weaponizedplastic/weaponizedplastic.github.io/README.md

# weaponizedplastic.github.io

## Deploy Notes

    gem install --user-install bundler jekyll
    bundler (will install dependencies)
    bundler exec jekyll serve
