weaponizedplastic/weaponizedplastic.github.io/_posts/2025-04-02-rules.markdown

---
layout: post
title:  "WPFL Rules - 2025"
date:   2025-04-02 12:01:44 -0400
categories: rules
---

# Rules (Final as of 6/13/2025)

## A. General Safety

 1. Robots are only to be powered on **INSIDE THE ARENA**.
 2. **ALL ROBOTS MUST PASS SAFETY TECH**. Safety tech will verify that the robot meets the following three rules:
 3. All weapons must have a physical locking mechanism that prevents unintended startup. The locking mechanism must be engaged at all times the robot is outside the arena.
 4. Robots must be failsafe: when the radio is switched off, they must spin down all weapons and cease all movement.
 5. Battery voltages must not exceed 50V. Batteries must be protected from direct hit. If at any time during a match, the battery becomes exposed the robot will immediately forfeit the match.

Note: it is recommended to have a power indicator light and an easily accessed power switch. These will likely be required at future events.

## B. General Specifications

 1. **ALL WEAPONS MUST BE 3D PRINTED** - that means: NO POLYCARBONATE SHEET GOODS, NO METAL, NO FIRE/EXPLOSIVES, NO FLUIDS, NO EMPS/JAMMING. NO PROJECTILE WEAPONS. Don't be clever here - you will fail safety tech.
 2. Robots should have an active weapon system, actuated by a mechanism other than the drivetrain - robots that lack an active weapon system will generally be scored lower by judges. For the purpose of this section, our definition of "active weapons" follows the [NHRL rules](https://wiki.nhrl.io/wiki/index.php?title=NHRL_Open_Rules_-_2025#Weapon_Systems).
 3. No metal may be used as a cutting/impact edge in a weapon - for example, a screw body or head may not be designed to make contact with an opponents robot.
 4. The robot body should be primarily 3d printed (the use of exotic/engineered plastics, such as fiber reinforced plastics, TPU, etc are allowed). Plastic sheet material not exceeding 1mm in thickness may be used to protect electronics, batteries, and drive mechanisms. The use of "weaker than plastic" materials is allowed - for example: paper, cardboard, styrofoam, etc. Metal fasteners may be used, but should not protrude from the body of the robot.
 5. Maximum Weight: 1kg
 6. Maximum Size: must fit in a box 30cm x 30cm x 30cm AT ALL TIMES
 7. Radios must use the following frequencies: TODO.

## C. Arena Specifications

 1. Arena is approximately 4ft x 4ft x 2ft tall.
 2. Floor is plywood, painted black. Walls are 1/4" Polycarbonate.

## D. Combat Rules

 1. Each match will last for 3 minutes.
 2. Brackets will generally be double elimination.
 3. A competitor may forfeit at any time to prevent further damage to their robot.
 4. If a robot appears incapacitated, judges will start a 10 second count down. If the robot fails to move during this 10 second window, it will forfeit the match.
 5. A robot may only pin and hold a robot for 15 seconds. Judges will instruct competitors when they must separate.
 6. In the event that both robot survive the full match, judges shall decide the winner.
 7. We aim to keep the arena quite active and avoid downtime - competitors should keep this in mind when selecting battery chargers and quantity of batteries to bring. Competitors will have at least 15 minutes between matches, and will not have more than two matches within an hour block of time.

## E. Further Information

 1. Contact weaponizedplastic@gmail.com with any questions.
