weaponizedplastic/weaponizedplastic.github.io/_posts/2026-08-14-austin.markdown

---
layout: post
title:  "Next Up: Austin TX, October 24, 2026"
date:   2026-08-14 11:59:00 -0400
categories: event
---

Weaponized Plastic is hitting the road this fall - with an event at the ASMBLY makerspace in Austin Texas.
We'll continue to update this page with more info as it comes out - for now, here's the save the date poster:

<center>
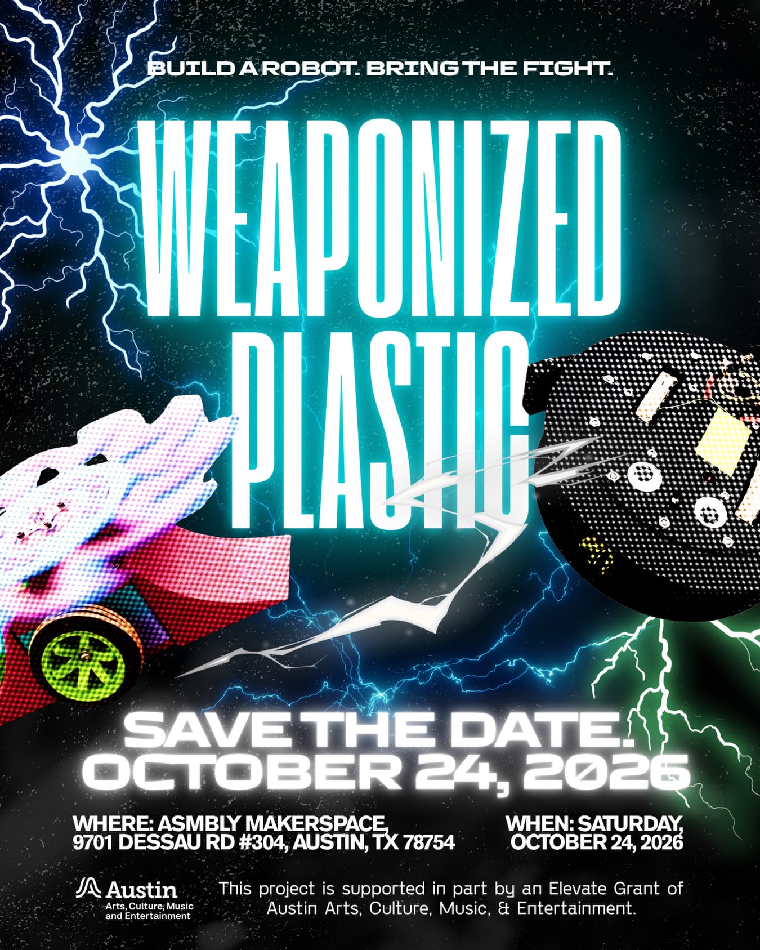
[picture p7: assets/austin_poster_2026.jpg]

</center>
