weaponizedplastic/weaponizedplastic.github.io/assets/tutorial/bottom-plate-v1.stl

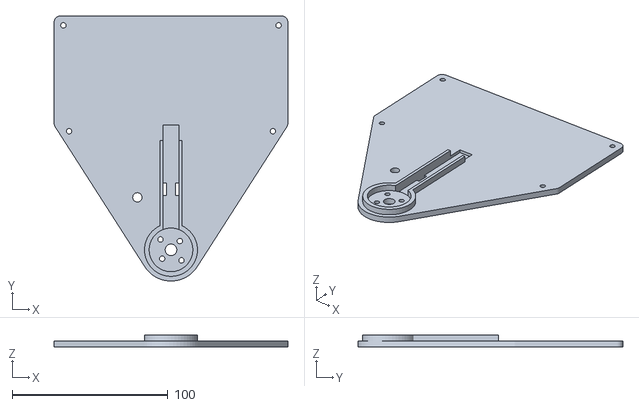
[picture p8: CAD file, 2026-04-16]
assets/tutorial/bottom-plate-v1.stl
150.0 x 170.0 x 8.00
