weaponizedplastic/weaponizedplastic.github.io/assets/tutorial/top-plate-v1.stl

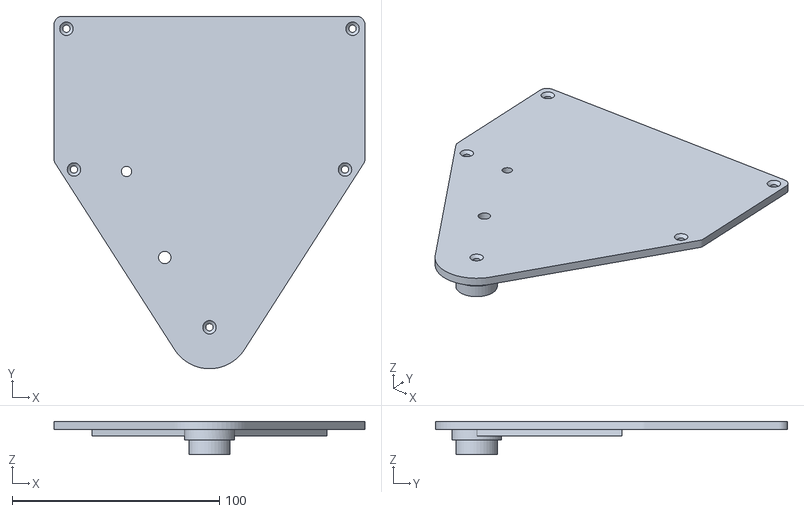
[picture p9: CAD file, 2026-04-16]
assets/tutorial/top-plate-v1.stl
150.0 x 170.0 x 16.0
