weaponizedplastic/weaponizedplastic.github.io/assets/tutorial/weapon-v1.stl

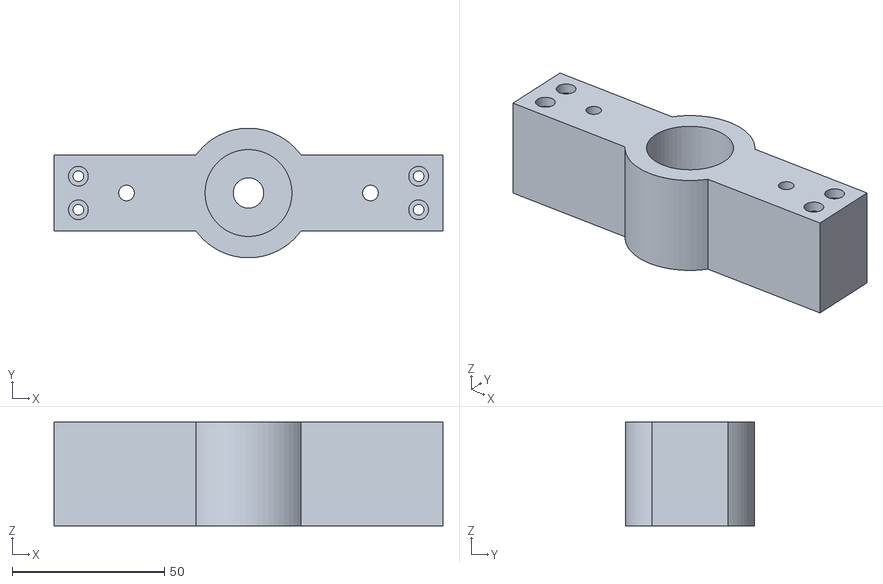
[picture p10: CAD file, 2026-04-16]
assets/tutorial/weapon-v1.stl
127.6 x 42.5 x 34.0
