weaponizedplastic/weaponizedplastic.github.io/assets/tutorial/body-v1.stl

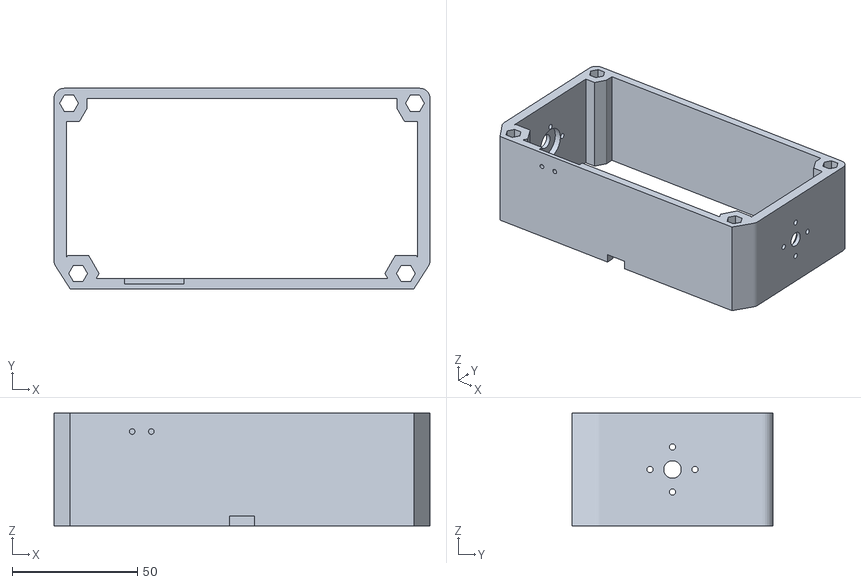
[picture p11: CAD file, 2026-04-16]
assets/tutorial/body-v1.stl
150.0 x 80.0 x 45.0
