weaponizedplastic/weaponizedplastic.github.io/assets/tutorial/rx-setup-4.jpeg

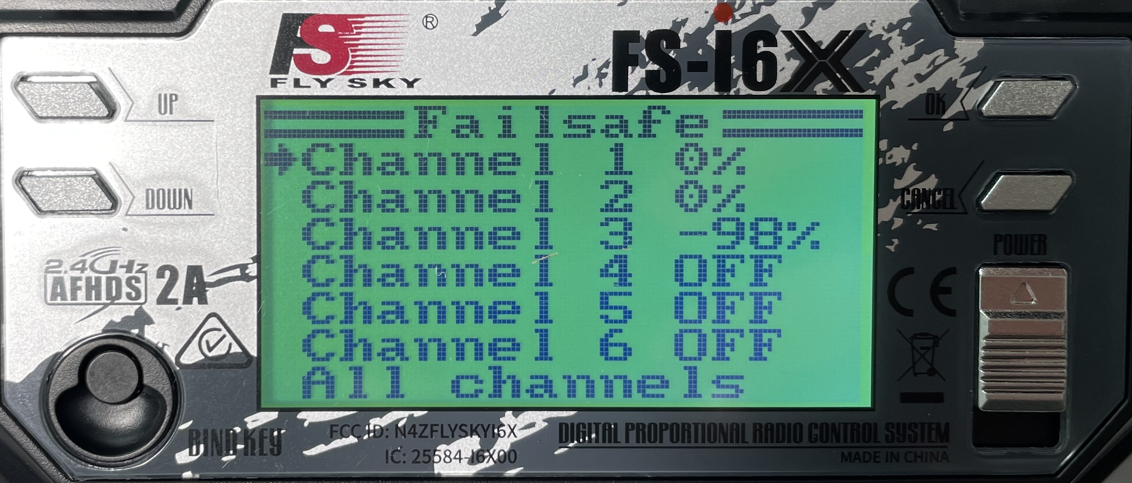
assets/tutorial/rx-setup-4.jpeg
