weaponizedplastic/weaponizedplastic.github.io/(commit log)

2025-03-14 add landing page
2025-04-14 add battery voltage limit
2026-04-09 Specifically allow balsa wood (#4)
    Updated rule regarding allowed materials for robot construction.
2026-04-14 update bill of materials
2026-04-16 finish tutorial
    [body-v1.stl, bottom-plate-v1.stl, top-plate-v1.stl, weapon-v1.stl]
2026-04-16 solder the jumper
